Ainacteru/GO/pcb/GO.step

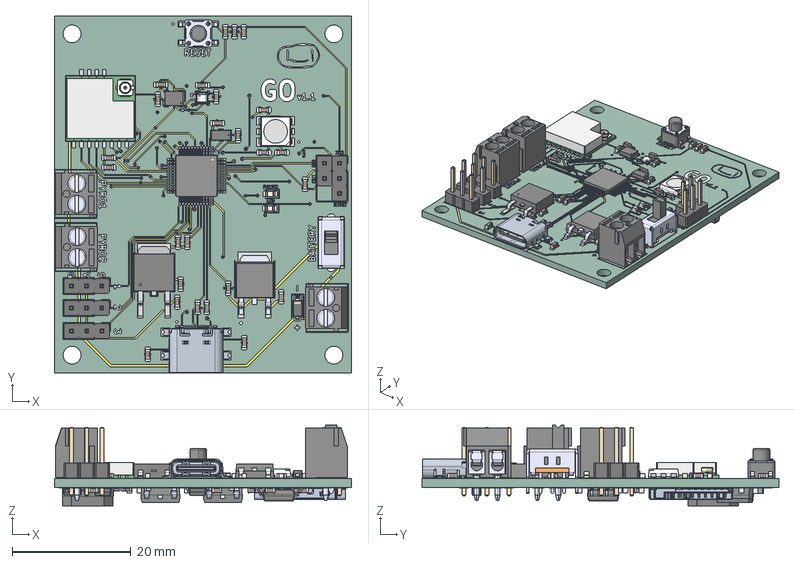
[picture p1: CAD file, 2026-05-19]
pcb/GO.step
50.0 x 60.0 x 13.6 mm
PinHeader_1x03_P254mm_Vertical x 4
C_0603_1608Metric x 37
OSTTE020104 x 3
User_Library-IPEX
Extruded
LED_0603_1608Metric x 2
ATSAMD21G18A-AU x 49
OS102011MS2QN1
_16P_7_35_3D_
MC78M06CDTRKG
PTS 647 SN50 SMTR2 LFS
IN-P55TATRGB
PinHeader_1x02_P254mm_Vertical
D_SOD-123 x 3
C_0402_1005Metric x 2
Fuse_0603_1608Metric x 2
IRFR9120NTRPBF x 2
SMT-0827-S-HT-R
SOT-23
W25Q32JVSSIQ
L_0402_1005Metric
fc_copper
fc_pad
fc_via
fc_silkscreen x 2
fc_PCB
