Ainacteru/GO/pcb/fc.kicad_pcb

## KiCad design pcb/fc.kicad_pcb (2026-05-14)

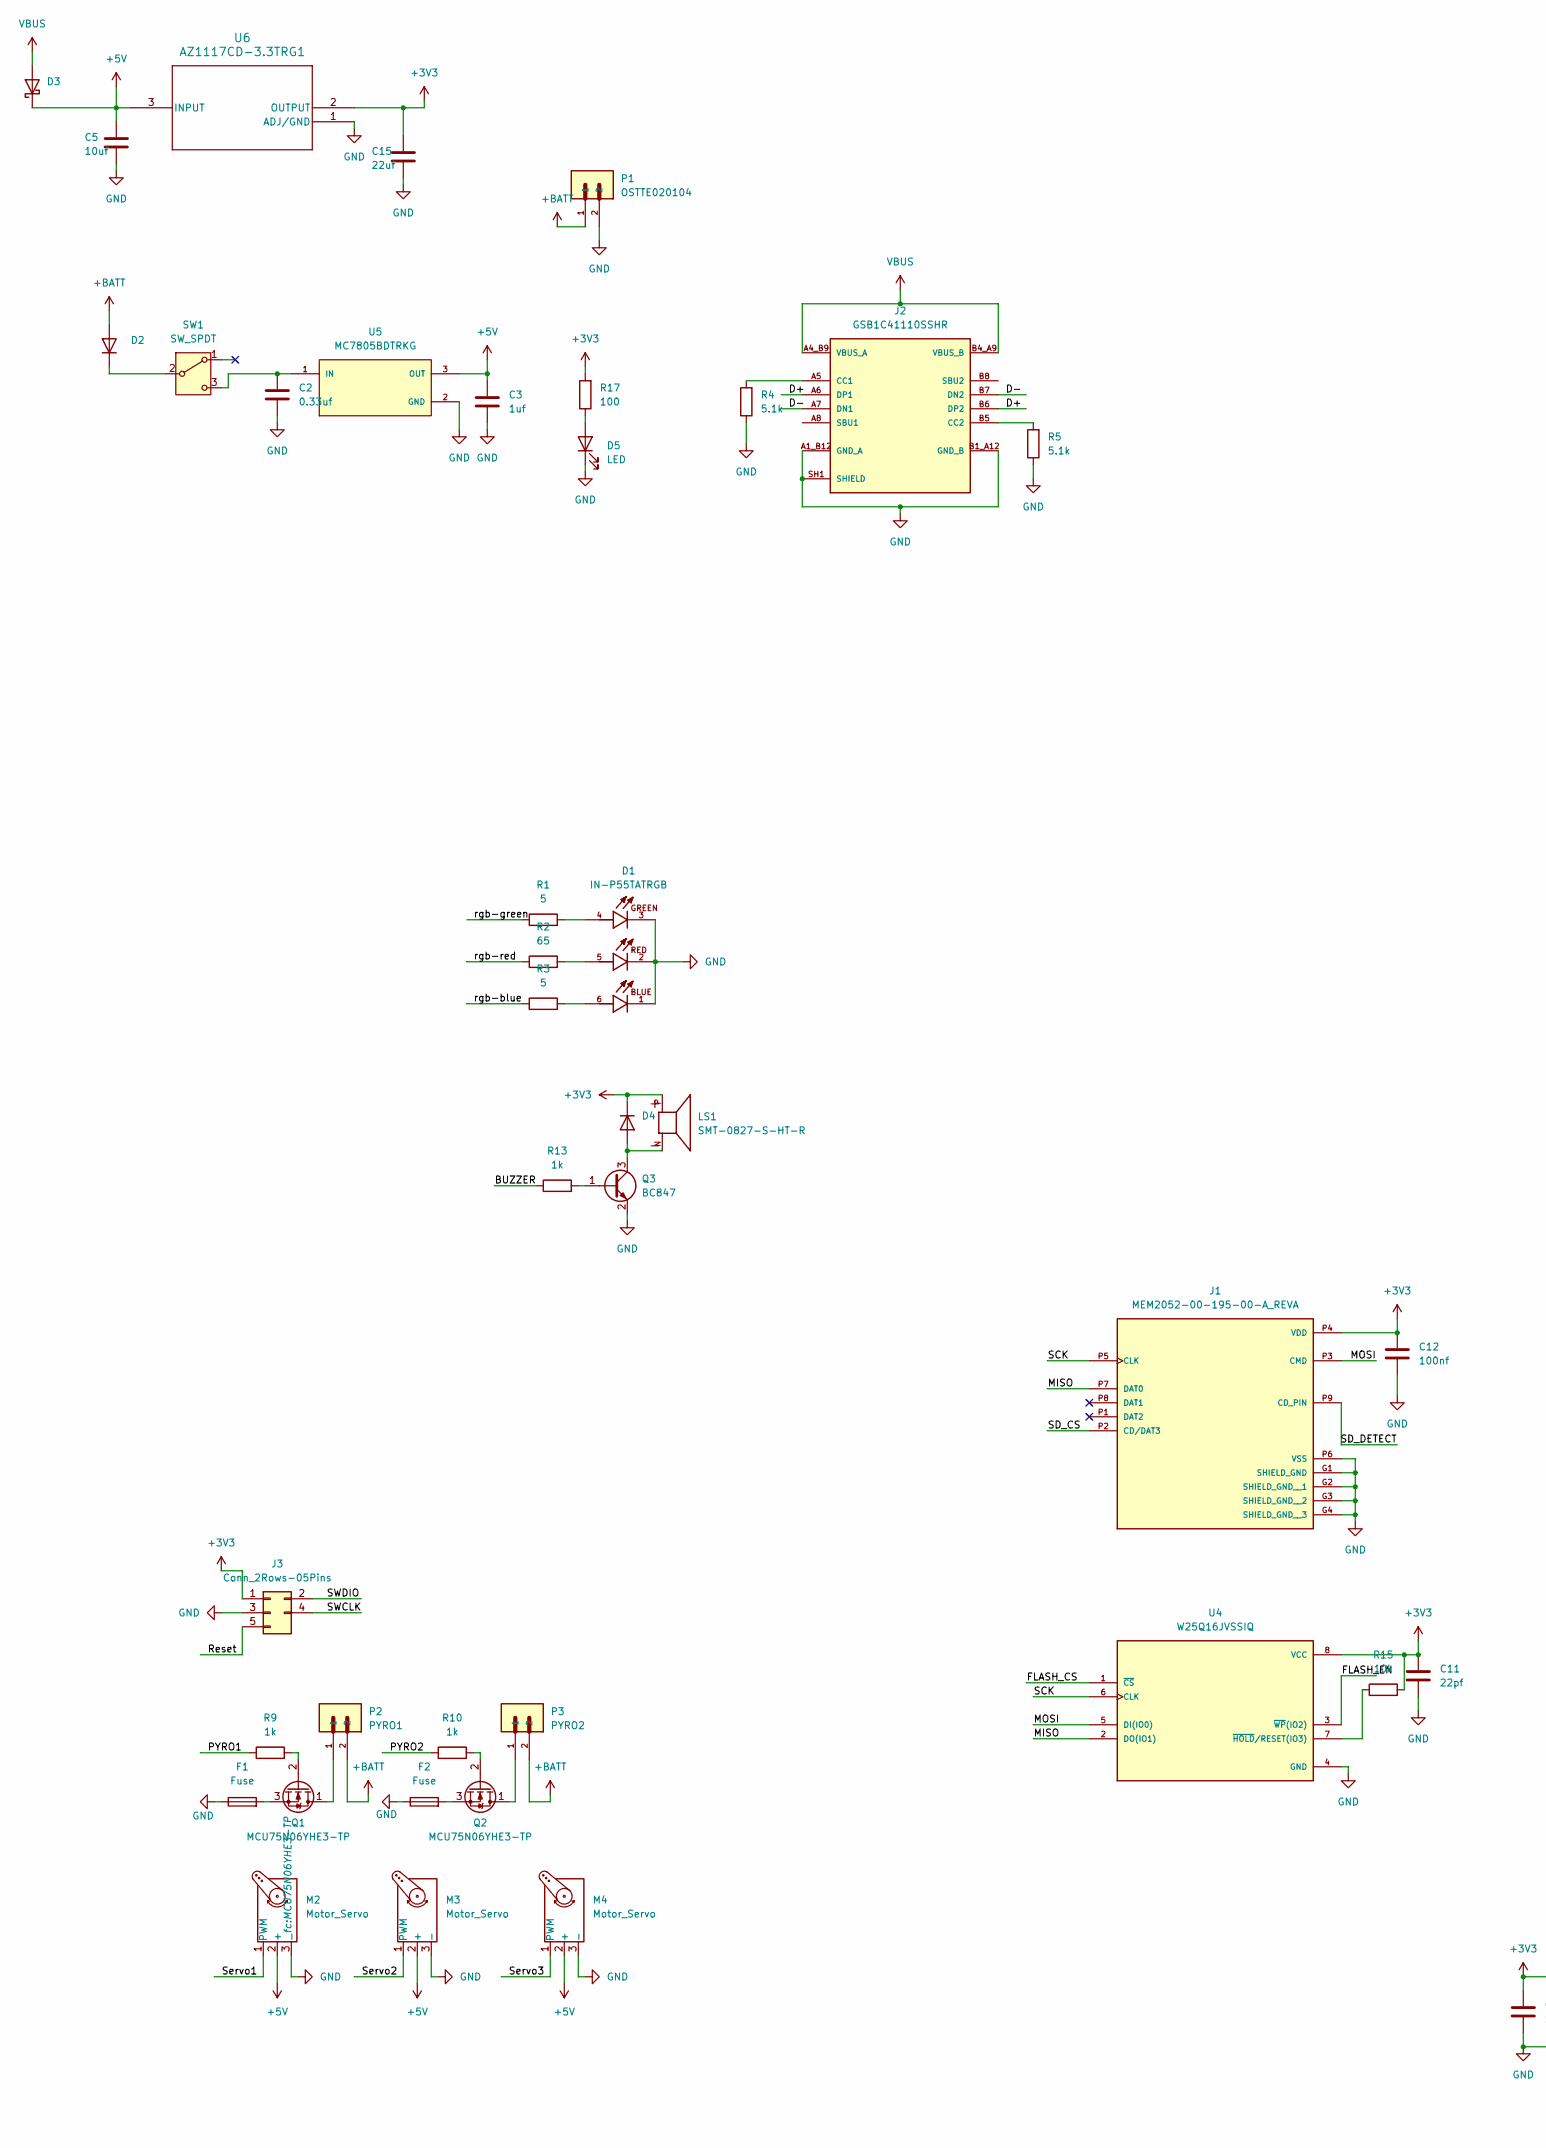
[picture p2: schematic fc.kicad_sch, part in row 1, column 1]

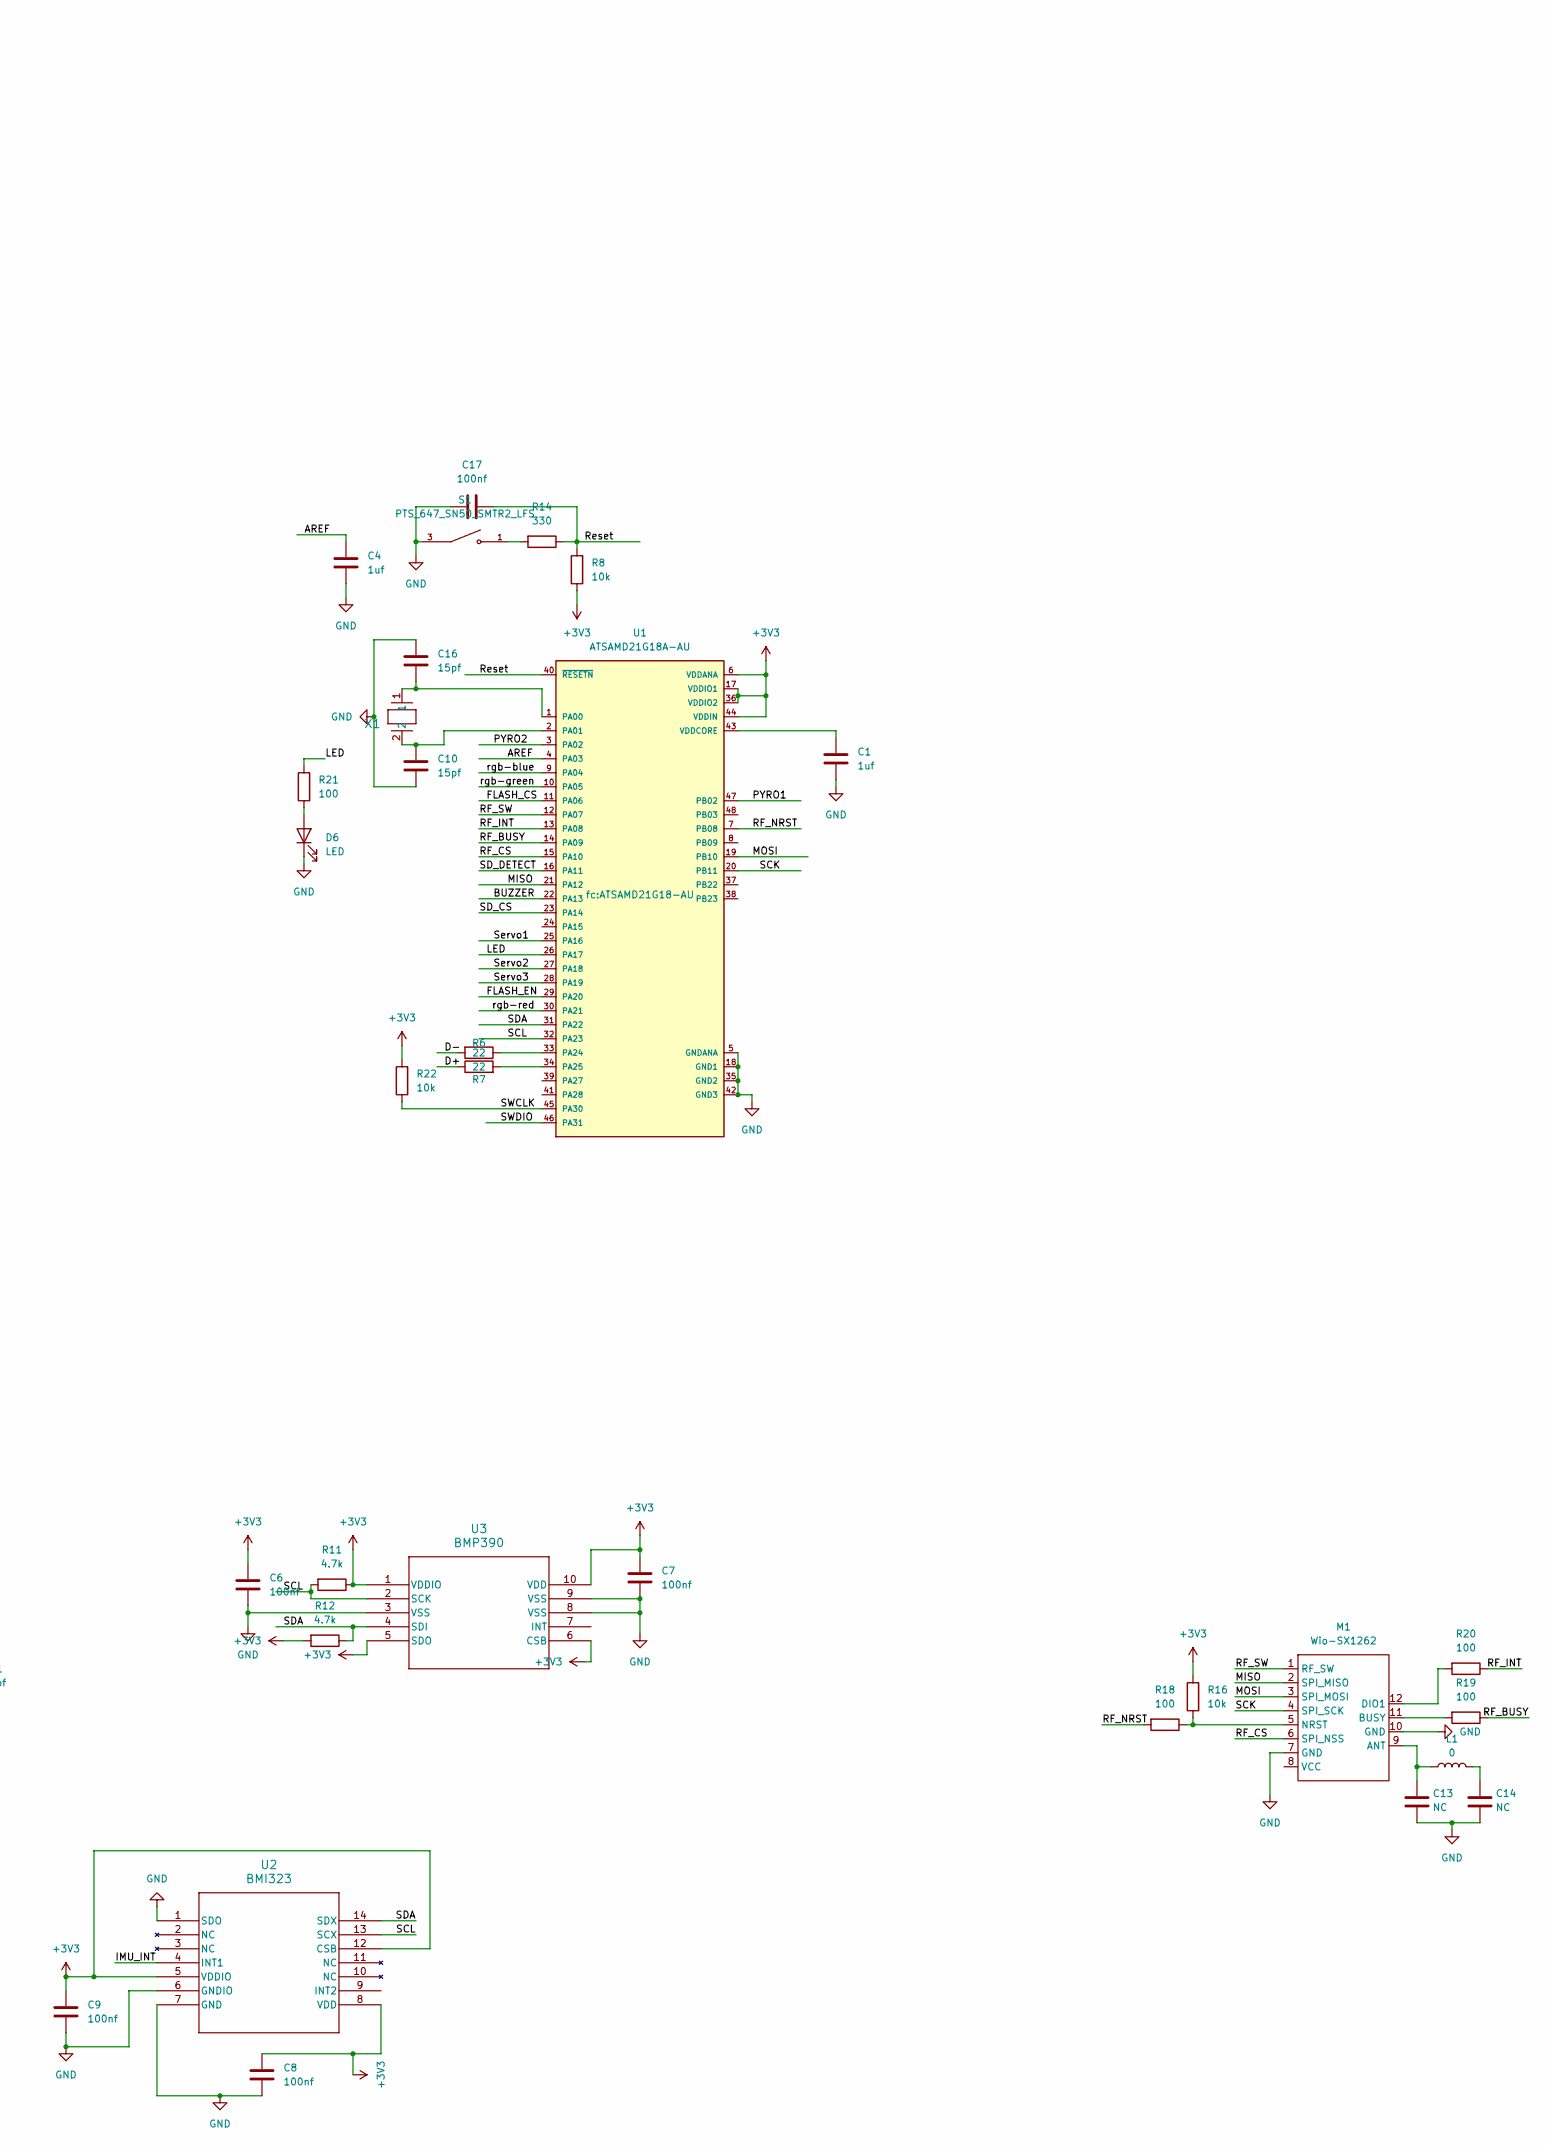
[picture p3: schematic fc.kicad_sch, part in row 1, column 2]

Parts:
C1, C3, C4: 1uf; 0603-cap
C2: 0.33uf; 0603-cap
C5: 10uf; 0603-cap
C6, C7, C8, C9, C12, C17: 100nf; 0603-cap
C10, C16: 15pf; 0603-cap
C11: 22pf; 0603-cap
C13, C14: NC; C_0402_1005Metric
C15: 22uf; 0603-cap
D1: IN-P55TATRGB; LED_IN-P55TATRGB; PARTREV 1.0
D2, D3, D4: D_SOD-123
D5, D6: LED; LED_0603_1608Metric
F1, F2: Fuse; Fuse_0603_1608Metric
J1: MEM2052-00-195-00-A_REVA; GCT_MEM2052-00-195-00-A_REVA; PARTREV A
J2: GSB1C41110SSHR; AMPHENOL_GSB1C41110SSHR; PARTREV AX1; DigiKey_Part_Number 664-GSB1C41110SSHRCT-ND
J3: Conn_2Rows-05Pins; PinSocket_2x03_odd
L1: 0; L_0402_1005Metric
LS1: SMT-0827-S-HT-R; XDCR_SMT-0827-S-HT-R; PARTREV 31/03/20
M1: Wio-SX1262
M2, M3, M4: Motor_Servo; PinHeader_1x03_P2.54mm_Vertical
P1: OSTTE020104; OST_OSTTE020104
P2: PYRO1; OST_OSTTE020104
P3: PYRO2; OST_OSTTE020104
Q1, Q2: MCU75N06YHE3-TP
Q3: BC847; SOT-23
R1, R3: 5; R_0603_1608Metric
R2: 65; R_0603_1608Metric
R4, R5: 5.1k; R_0603_1608Metric
R6, R7: 22; R_0603_1608Metric
R8, R15, R16, R22: 10k; R_0603_1608Metric
R9, R10, R13: 1k; R_0603_1608Metric
R11, R12: 4.7k; R_0603_1608Metric
R14: 330; R_0603_1608Metric
R17, R18, R19, R20, R21: 100; R_0603_1608Metric
S1: PTS_647_SN50_SMTR2_LFS; SW_PTS_647_SN50_SMTR2_LFS; PARTREV 4 Apr 22
SW1: SW_SPDT; SW_OS102011MS2QN1
U1: ATSAMD21G18A-AU; ATSAMD21G18-AU
U2: BMI323; BMI323_BOS
U3: BMP390
U4: W25Q16JVSSIQ
U5: MC7805BDTRKG; DPAK229P990X238-4N; PARTREV 27
U6: AZ1117CD-3.3TRG1; TO252-2-3.3V_DIO
X1: FC-135 32.7680KA-A5; XTAL_FC-135_EPS

Connections:
+3V3: C6.1, C7.1, C8.1, C9.1, C11.1, C12.1, C15.1, D4.1 (K), J1.P4 (VDD), J3.1, LS1.P, R8.1, R11.1, R12.2, R15.2, R16.2, R17.2, R22.2, U1.6 (VDDANA), U1.17 (VDDIO1), U1.36 (VDDIO2), U1.44 (VDDIN), U2.5 (VDDIO), U2.8 (VDD), U2.12 (CSB), U3.1 (VDDIO), U3.5 (SDO), U3.6 (CSB), U3.10 (VDD), U4.8 (VCC), U6.2 (OUTPUT)
+5V: C3.1, C5.1, D3.1 (K), M2.2 (+), M3.2 (+), M4.2 (+), U5.3 (OUT), U6.3 (INPUT)
+BATT: D2.2 (A), P1.1, P2.2, P3.2
/AREF: C4.1, U1.4 (PA03)
/BUZZER: R13.1, U1.22 (PA13)
/FLASH_CS: U1.11 (PA06), U4.1 (~CS)
/FLASH_EN: U1.29 (PA20), U4.3 (~WP(IO2))
/IMU_INT: U2.4 (INT1)
/LED: R21.2, U1.26 (PA17)
/MISO: J1.P7 (DAT0), M1.2 (SPI_MISO), U1.21 (PA12), U4.2 (DO(IO1))
/MOSI: J1.P3 (CMD), M1.3 (SPI_MOSI), U1.19 (PB10), U4.5 (DI(IO0))
/PYRO1: R9.1, U1.47 (PB02)
/PYRO2: R10.1, U1.3 (PA02)
/RF_BUSY: R19.1, U1.14 (PA09)
/RF_CS: M1.6 (SPI_NSS), U1.15 (PA10)
/RF_INT: R20.1, U1.13 (PA08)
/RF_NRST: R18.2, U1.7 (PB08)
/RF_SW: M1.1 (RF_SW), U1.12 (PA07)
/Reset: C17.2, J3.5, R8.2, R14.1, U1.40 (~RESETN)
/SCK: J1.P5 (CLK), M1.4 (SPI_SCK), U1.20 (PB11), U4.6 (CLK)
/SCL: R11.2, U1.32 (PA23), U2.13 (SCX), U3.2 (SCK)
/SDA: R12.1, U1.31 (PA22), U2.14 (SDX), U3.4 (SDI)
/SD_CS: J1.P2 (CD/DAT3), U1.23 (PA14)
/SD_DETECT: J1.P9 (CD_PIN), U1.16 (PA11)
/SWCLK: J3.4, R22.1, U1.45 (PA30)
/SWDIO: J3.2, U1.46 (PA31)
/Servo1: M2.1 (PWM), U1.25 (PA16)
/Servo2: M3.1 (PWM), U1.27 (PA18)
/Servo3: M4.1 (PWM), U1.28 (PA19)
/rgb-blue: R3.1, U1.9 (PA04)
/rgb-green: R1.1, U1.10 (PA05)
/rgb-red: R2.1, U1.30 (PA21)
GND: C1.2, C2.2, C3.2, C4.2, C5.2, C6.2, C7.2, C8.2, C9.2, C10.1, C11.2, C12.2, C13.2, C14.2, C15.2, C16.1, C17.1, D1.1, D1.2, D1.3, D5.1 (K), D6.1 (K), F1.1, F2.1, J1.G1 (SHIELD_GND), J1.G2 (SHIELD_GND__1), J1.G3 (SHIELD_GND__2), J1.G4 (SHIELD_GND__3), J1.P6 (VSS), J2.A1_B12 (GND_A), J2.B1_A12 (GND_B), J2.SH1 (SHIELD), J2.SH2 (SHIELD), J2.SH3 (SHIELD), J2.SH4 (SHIELD), J3.3, M1.7 (GND), M1.10 (GND), M2.3 (-), M3.3 (-), M4.3 (-), P1.2, Q3.2 (E), R4.1, R5.1, S1.3, S1.4, U1.5 (GNDANA), U1.18 (GND1), U1.35 (GND2), U1.42 (GND3), U2.1 (SDO), U2.6 (GNDIO), U2.7 (GND), U3.3 (VSS), U3.8 (VSS), U3.9 (VSS), U4.4 (GND), U5.2 (GND), U6.1 (ADJ/GND)
unnamed: C14.1, L1.2
unnamed: D1.4, R1.2
unnamed: D1.5, R2.2
unnamed: D1.6, R3.2
unnamed: D2.1 (K), SW1.2 (B)
unnamed: D4.2 (A), LS1.N, Q3.3 (C)
unnamed: D5.2 (A), R17.1
unnamed: D6.2 (A), R21.1
unnamed: J2.A5 (CC1), R4.2
unnamed: J2.B5 (CC2), R5.2
unnamed: C13.1, L1.1, M1.9 (ANT)
unnamed: M1.11 (BUSY), R19.2
unnamed: M1.12 (DIO1), R20.2
unnamed: M1.5 (NRST), R16.1, R18.1
unnamed: P2.1, Q1.1 (D)
unnamed: Q1.2 (G), R9.2
unnamed: F1.2, Q1.3 (S)
unnamed: P3.1, Q2.1 (D)
unnamed: Q2.2 (G), R10.2
unnamed: F2.2, Q2.3 (S)
unnamed: Q3.1 (B), R13.2
unnamed: R14.2, S1.1, S1.2
unnamed: C2.1, SW1.3 (C), U5.1 (IN)
unnamed: C16.2, U1.1 (PA00), X1.1
unnamed: C10.2, U1.2 (PA01), X1.2
unnamed: R6.1, U1.33 (PA24)
unnamed: R7.2, U1.34 (PA25)
unnamed: C1.1, U1.43 (VDDCORE)
unnamed: R15.1, U4.7 (~HOLD/RESET(IO3))
VBUS: D3.2 (A), J2.A4_B9 (VBUS_A), J2.B4_A9 (VBUS_B)

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
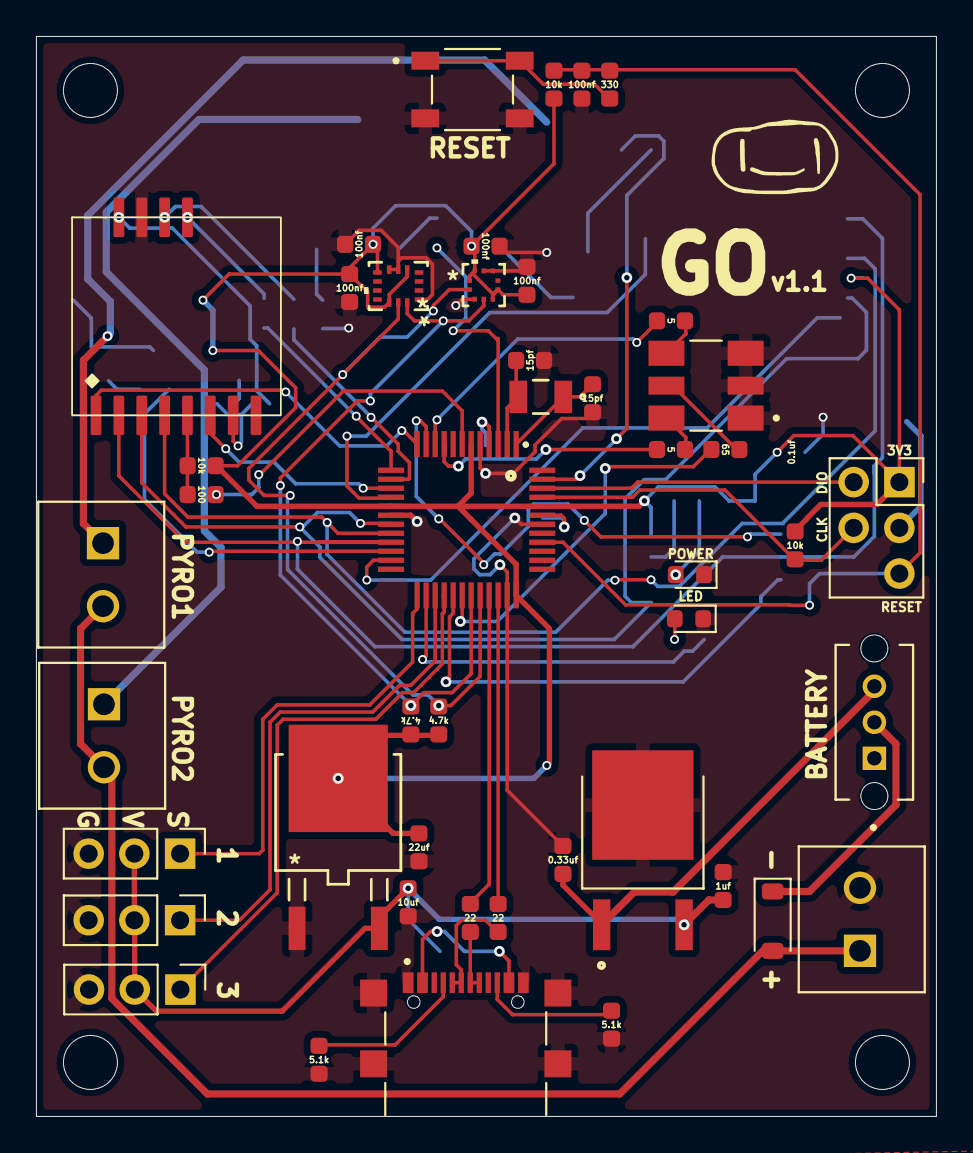
[picture p4: board fc.kicad_pcb from above]

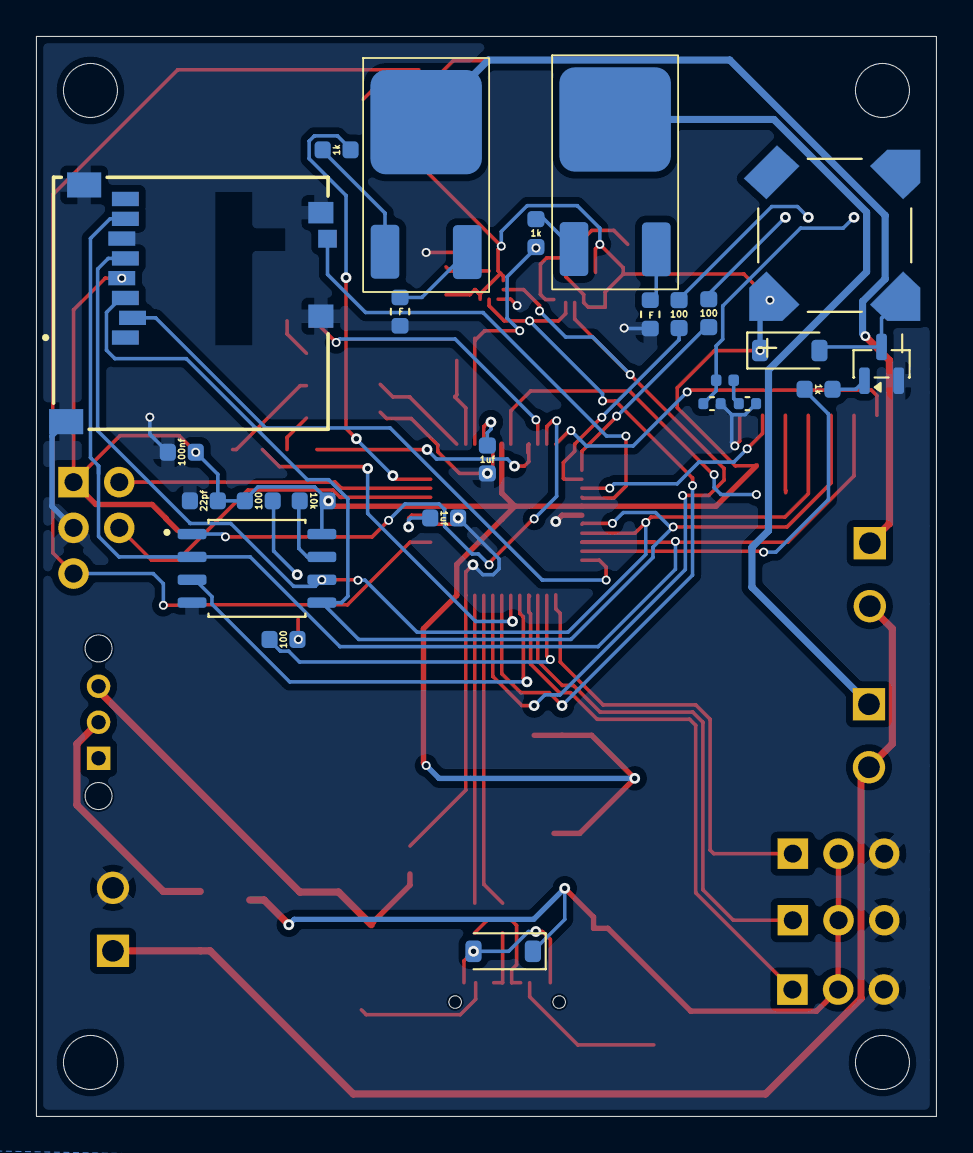
[picture p5: board fc.kicad_pcb from below]

Board: 2 copper layers, 50.0 x 60.0 mm, 71 parts (25 on the bottom side), 64 nets.
