Ainacteru/GO/(commit log)

2026-05-16 trying servo code but rust is kinda hard
2026-05-17 servo works and starting led stuff
2026-05-18 rgb led stuff works almost just need to change clock channels, also cool panic handler! also tested servos
2026-05-19 read me because i can't code
    [GO.step, fc.kicad_pcb, fc.kicad_sch]
2026-05-22 trying to read temperatures
2026-05-22 completed temperature, pressure and altitude readings, however the numbers are off by a little bit
2026-05-22 baro is very jittery so gonna try to turn on oversampling and iir, maybe a filter if that doesnt help enough
    [bmp.rs, main.rs]
2026-06-23 imu and barometer now work!
2026-06-24 buzzer! and hot cross buns
    [buzzer.rs, lib.rs, main.rs, time_driver.rs]
2026-06-26 somehow implemented flash turns out i just had to slather solder paste everywhere to fix the issue
    [flash.rs, lib.rs, main.rs]
2026-07-03 fixed records and timestamp uses uom for measurement conversions
    [flash_writer.rs, main.rs]
2026-07-05 sd card tested yay, just need to test multi devices spi
2026-07-23 refactoring imu code
2026-07-26 testing imu code
2026-07-26 complementary filter
2026-07-29 kalman filter and quaternions
2026-08-01 kalman filter prediction step alledgedly done
2026-08-01 kalman filter correction step
    [error.rs, imu.rs, kalman_filter.rs, main.rs]
2026-08-02 kalman filter atitude estimation alledgedly done??
2026-08-13 altitude kalman filter estimation i'm crine help
2026-08-14 help why is it drifting so much i'm confused and why is it negative sometimes
    [bmp.rs, kalman_filter.rs, main.rs]
2026-08-24 lwk the baro isn't working so i'm just going to write my own driver
2026-09-06 i'm so confused sometimes it drifts and seomtimes it doesn't but mostly doesn't
    [bmp.rs, error.rs, kalman_filter.rs, main.rs]
2026-09-24 a bunch of stuff, commands, kalman filter combination and run.sh flash.sh things
